dsechsan/haptic-steer/README.md

# A 2-DoF haptic controller which enables bidirectional interaction with a virtual rigid ball in a 3D environment.

## Architecture of the haptic interface system:
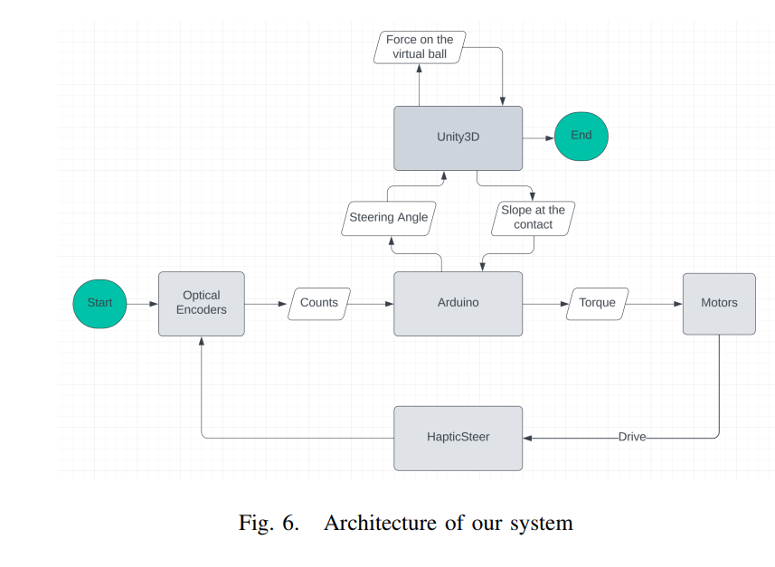
[picture p1: Images/architecture.png]
architecture


## Click on the images below to watch the videos:
**Demo:** <br>
watch_demo (https://www.youtube.com/watch?v=2q8rHm4gK60)
<br>
**Hardware setup:** <br>
watch_hw_setup (https://www.youtube.com/watch?v=D9nIS4LXtgA)
<br>
**Force feedback in Haptic Steer:** <br>
watch_fdbk (https://www.youtube.com/watch?v=WZXPGZhVnqc)
<br>

For complete details about the project, contact dchintada@ucsd.edu / rgutta@ucsd.edu
